wrs/aunisoma-hw/aunisoma-panel-controller/aunisoma-panel-controller.jpg

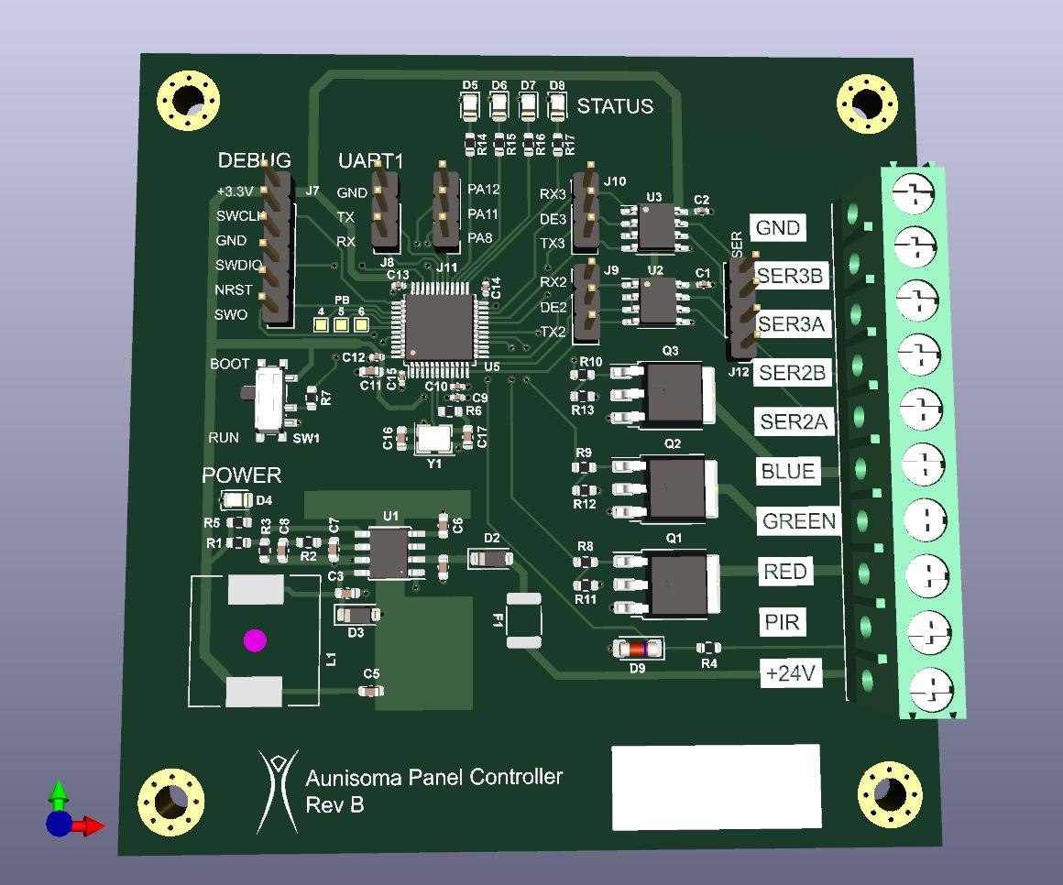
aunisoma-panel-controller/aunisoma-panel-controller.jpg
