wrs/aunisoma-hw/aunisoma-panel-controller/plot/aunisoma-panel-controller.pdf

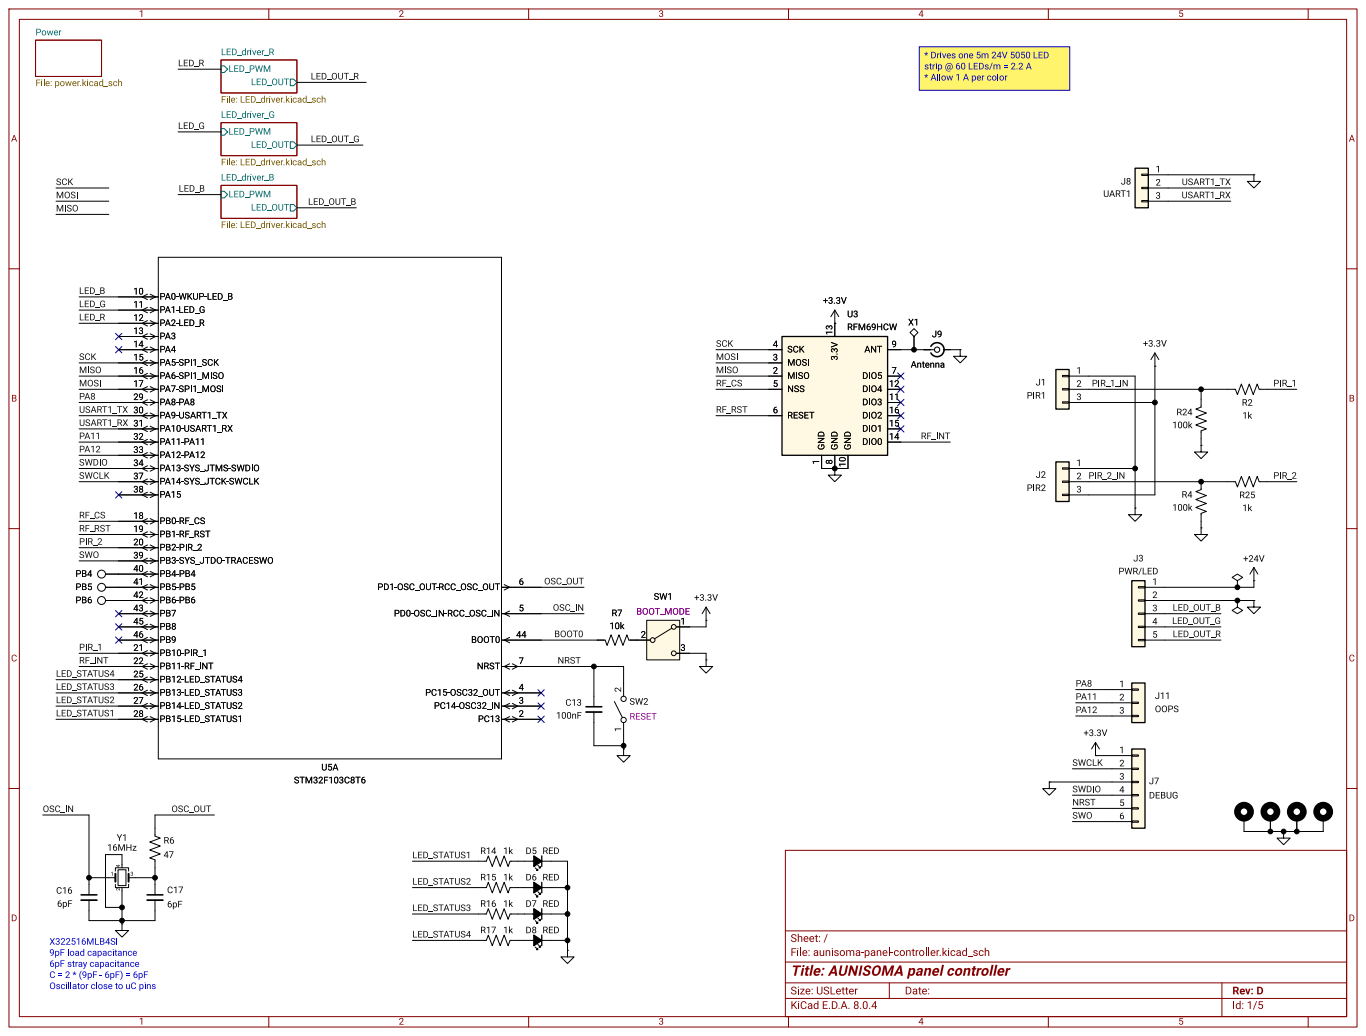
[picture p3: page 1]

File: LED_driver.kicad_sch Power File: power.kicad_sch

PIR_2 SWO MISO MOSI SCK

Id: 1/5 Title: AUNISOMApanelcontroller File: aunisoma-panel-controller.kicad_sch Sheet: /

6pF stray capacitance C = 2 * (9pF - 6pF) = 6pF Oscillator close to uC pins

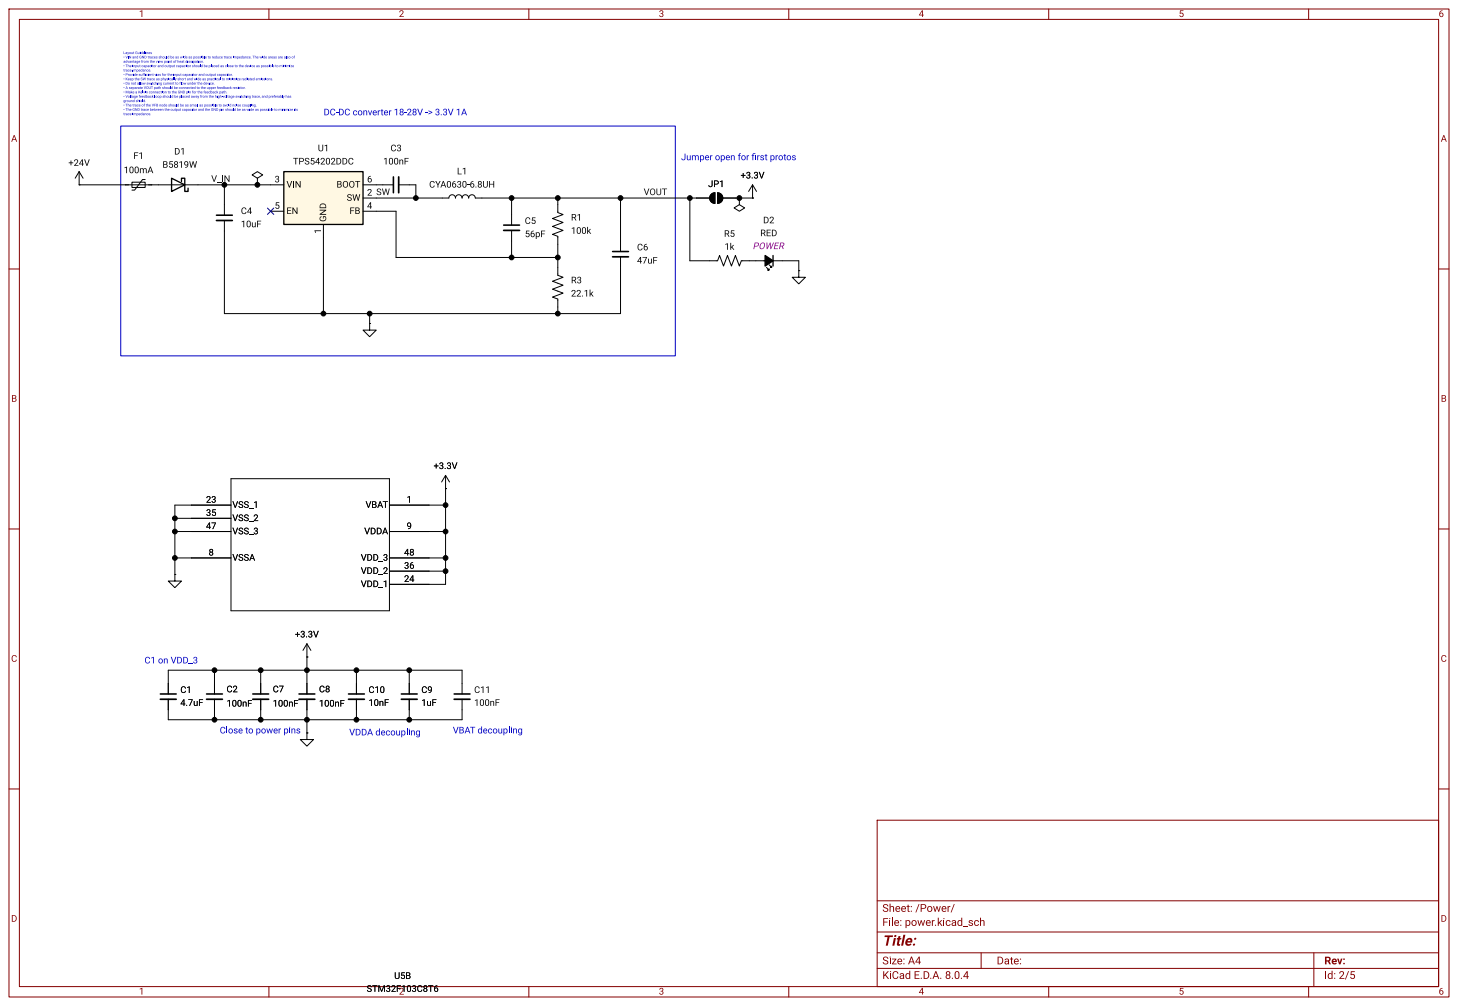
[picture p4: page 2]

Layout Guidelines þÿ " VIN and GNDtraces should be as wide as possible to reduce trace impedance. The wide areas are also of advantage from the view point of heat dissipation. þÿ " The input capacitor and output capacitor should be placed as close to the device as possible to minimize

trace impedance. þÿ " Provide sufficient vias for the input capacitor and output capacitor. þÿ " Keep the SWtrace as physically short and wide as practical to minimize radiated emissions. þÿ " Do not allow switching current to flow under the device. þÿ " A separate VOUTpath should be connected to the upper feedback resistor. þÿ " Make a Kelvin connection to the GNDpin for the feedback path. þÿ " Voltage feedback loop should be placed away from the high-voltage switching trace, and preferably has ground shield. þÿ " The trace of the VFBnode should be as small as possible to avoid noise coupling. þÿ " The GNDtrace between the output capacitor and the GNDpin should be as wide as possible to minimize its

Jumper open for first protos

Id: 2/5 Title: File: power.kicad_sch Sheet: /Power/ C11

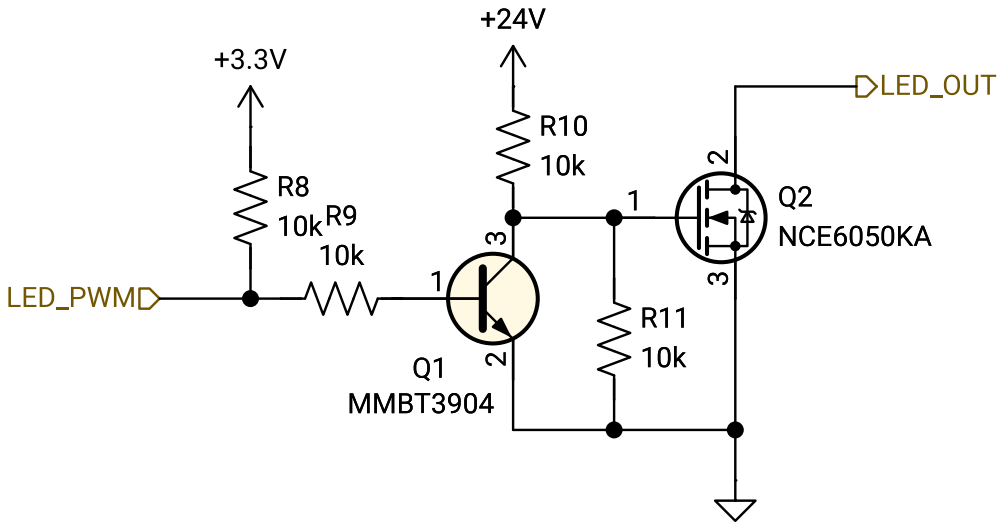
[picture p5: page 3]

Id: 3/5 Title: File: untitled.kicad_sch Sheet: /LED_driver_R/

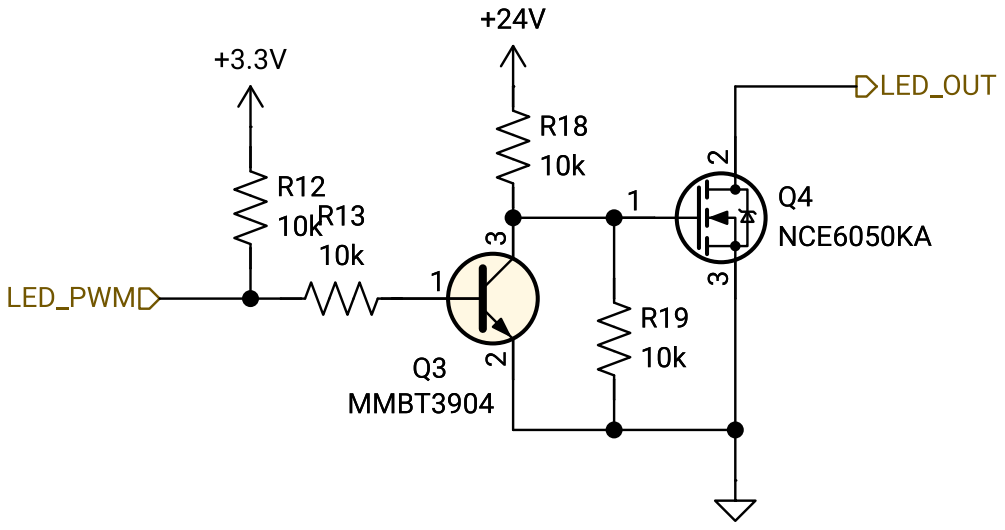
[picture p6: page 4]

Id: 4/5 Title: File: untitled.kicad_sch Sheet: /LED_driver_G/

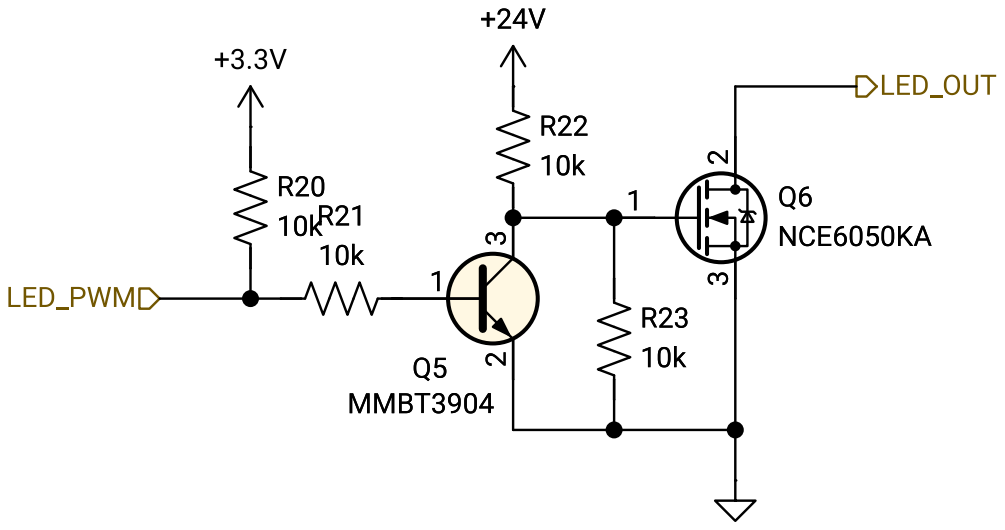
[picture p7: page 5]

Id: 5/5 Title: File: untitled.kicad_sch Sheet: /LED_driver_B/
