wrs/aunisoma-hw/aunisoma-panel-controller/plot/aunisoma-panel-controller-B_Cu.pdf

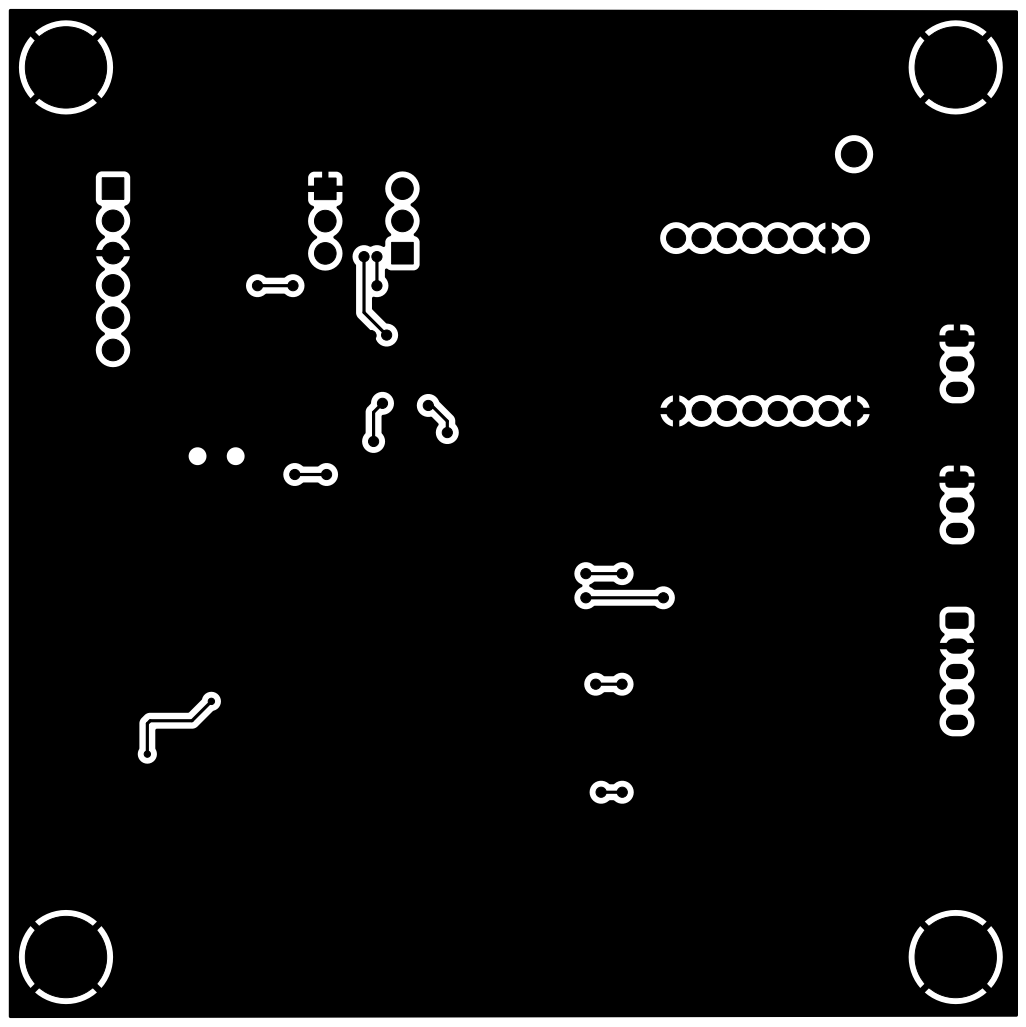
[picture p8: page 1]
