wrs/aunisoma-hw/aunisoma-panel-controller/plot/aunisoma-panel-controller-B_Mask.pdf

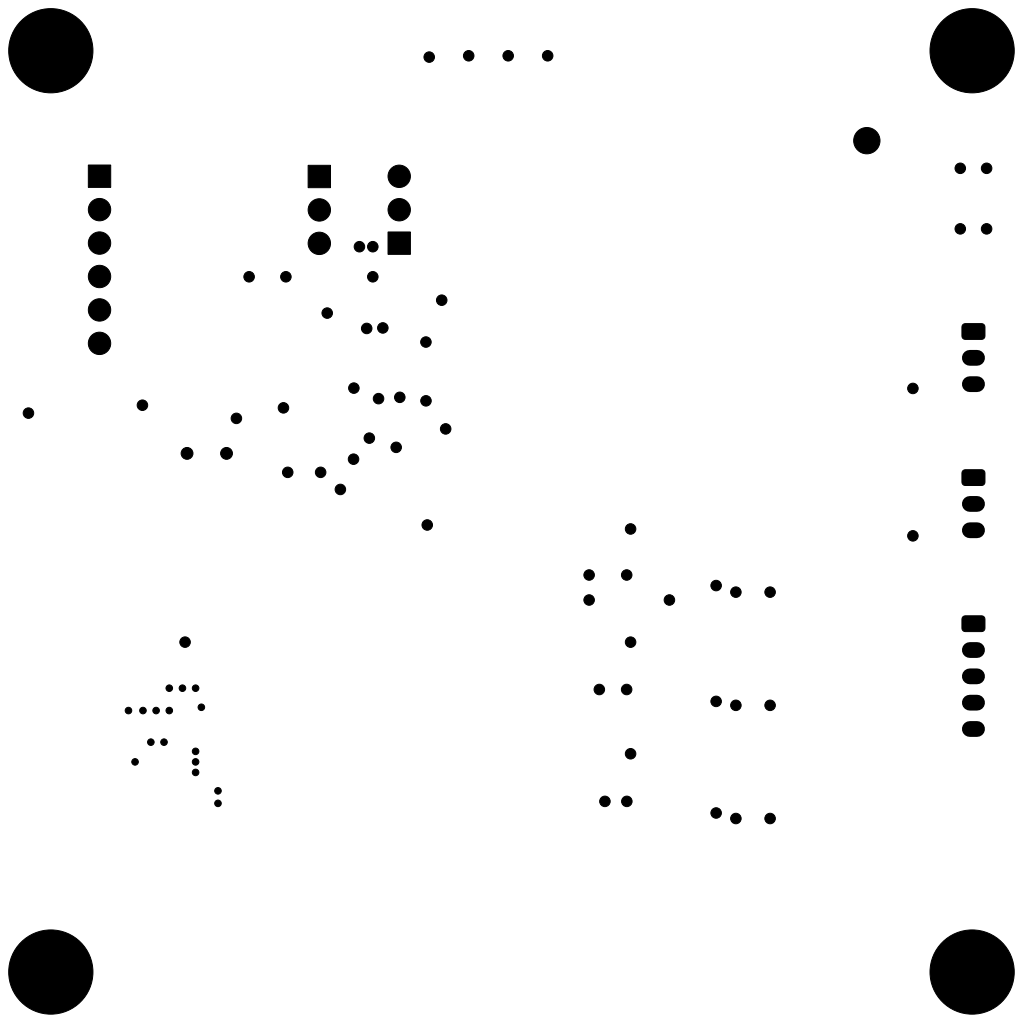
[picture p9: page 1]
