wrs/aunisoma-hw/aunisoma-panel-controller/plot/aunisoma-panel-controller-F_Cu.pdf

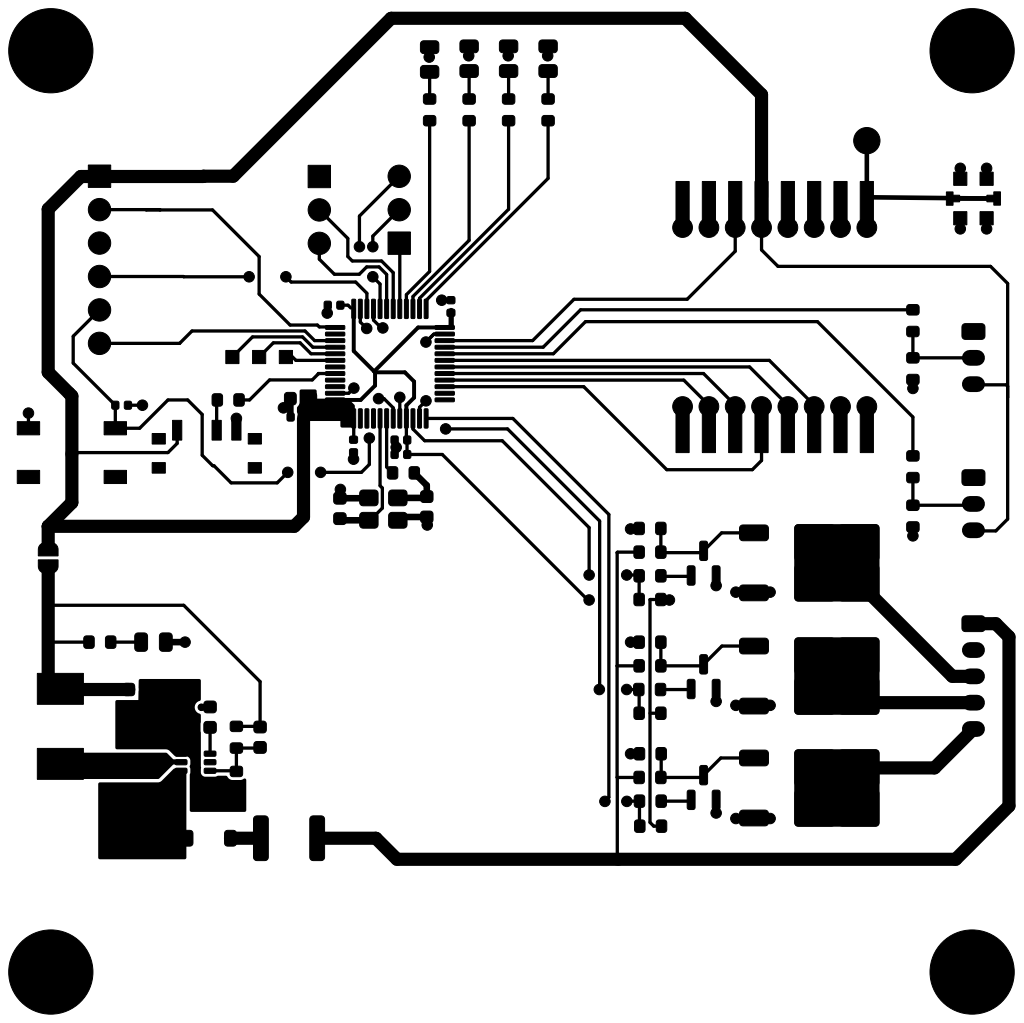
[picture p10: page 1]
