wrs/aunisoma-hw/aunisoma-panel-controller/plot/aunisoma-panel-controller-F_Mask.pdf

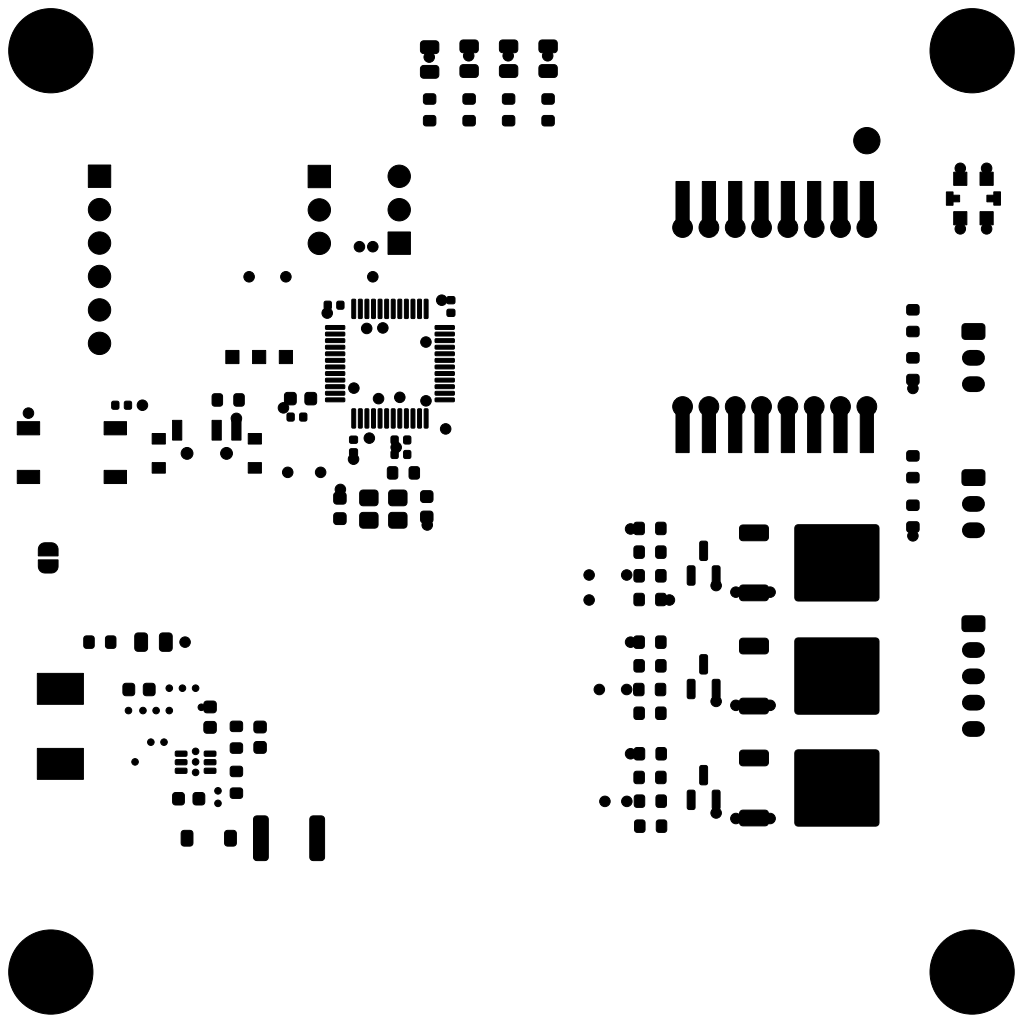
[picture p11: page 1]
