wrs/aunisoma-hw/aunisoma-panel-controller/plot/aunisoma-panel-controller-F_Paste.pdf

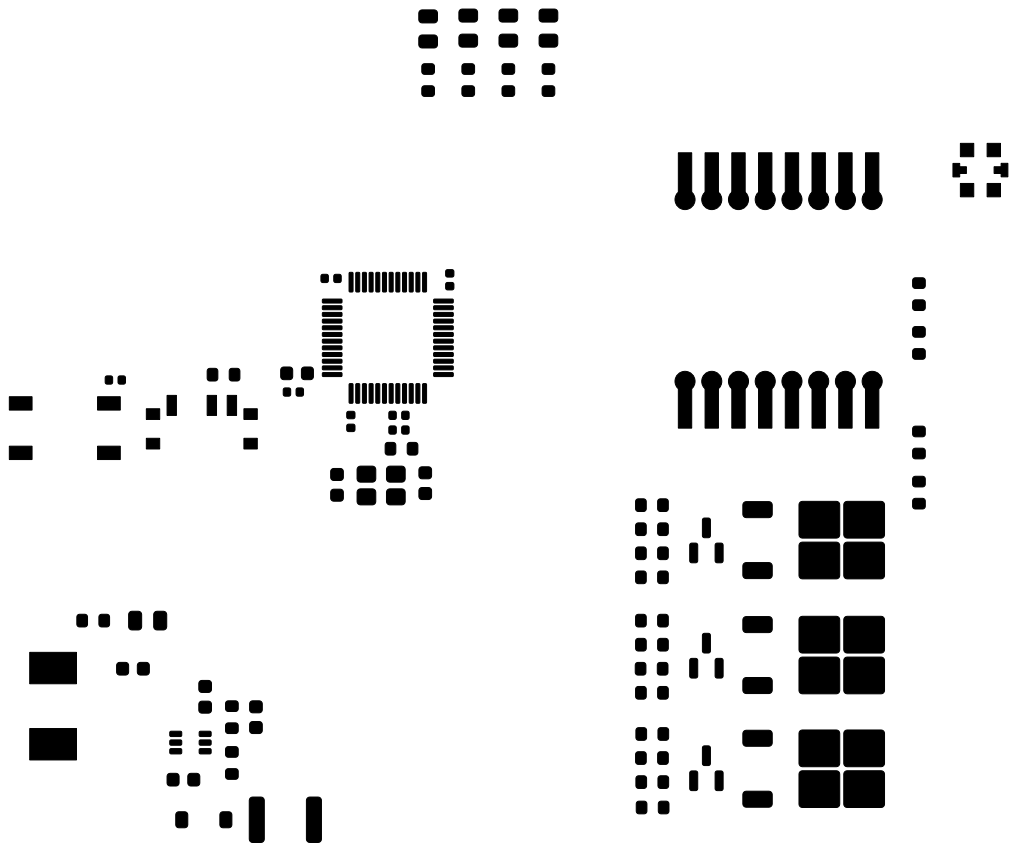
[picture p12: page 1]
