wrs/aunisoma-hw/aunisoma-panel-controller/plot/aunisoma-panel-controller-F_Silkscreen.pdf

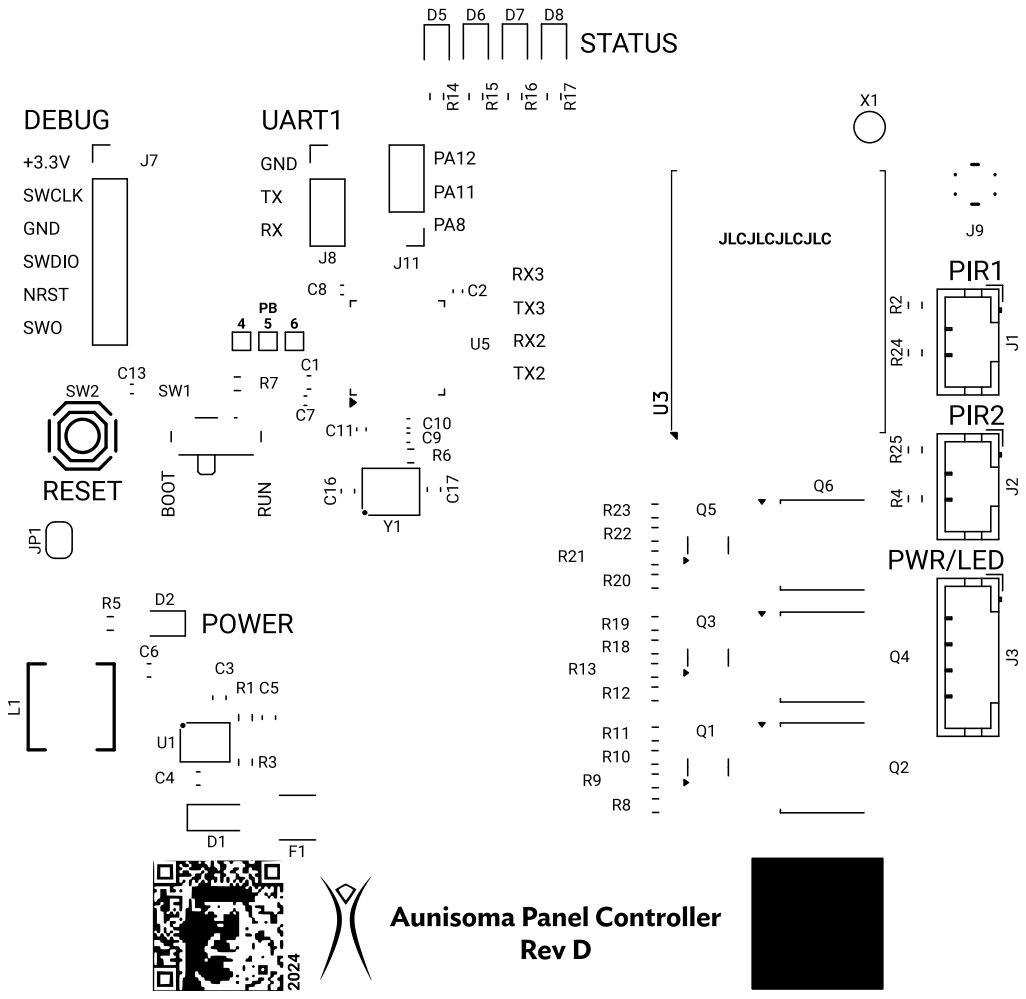
[picture p13: page 1]

JLCJLCJLCJLC NRST SWDIO DEBUG
