wrs/aunisoma-hw/aunisoma-pir/aunisoma-pir.kicad_pcb

## KiCad design aunisoma-pir/aunisoma-pir.kicad_pcb (2024-08-31)

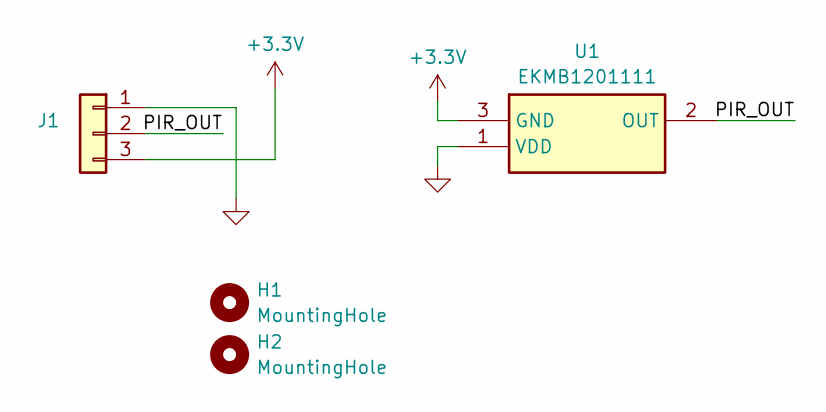
[picture p14: schematic aunisoma-pir.kicad_sch]

Parts:
H1, H2: MountingHole; MountingHole_3.2mm_M3
J1: PIR1; JST_PH_B3B-PH-K_1x03_P2.00mm_Vertical
U1: EKMB1201111; Mouser Part Number 769-EKMB1201111

Connections:
+3.3V: J1.3, U1.3 (GND)
/PIR_OUT: J1.2, U1.2 (OUT)
GND: J1.1, U1.1 (VDD)

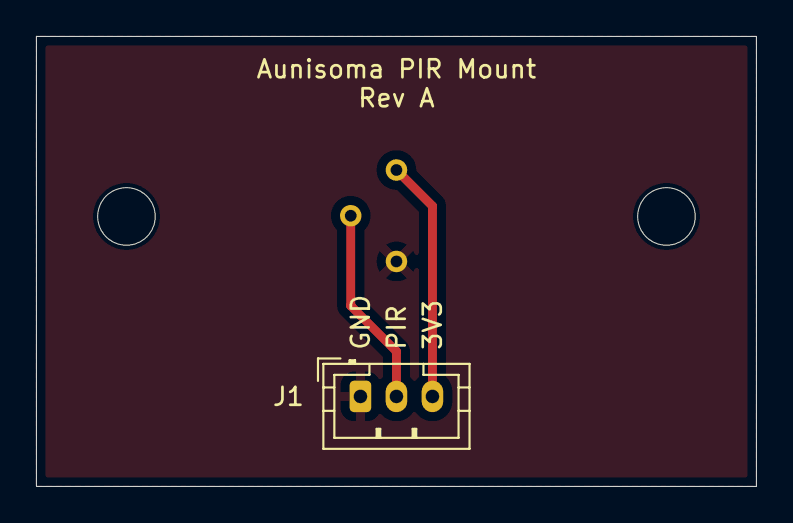
[picture p15: board aunisoma-pir.kicad_pcb from above]

Board: 2 copper layers, 40.0 x 25.0 mm, 4 parts (1 on the bottom side), 3 nets.
