wrs/aunisoma-hw/aunisoma-panel-controller/aunisoma-panel-controller.kicad_pcb

## KiCad design aunisoma-panel-controller/aunisoma-panel-controller.kicad_pcb (2024-08-31)

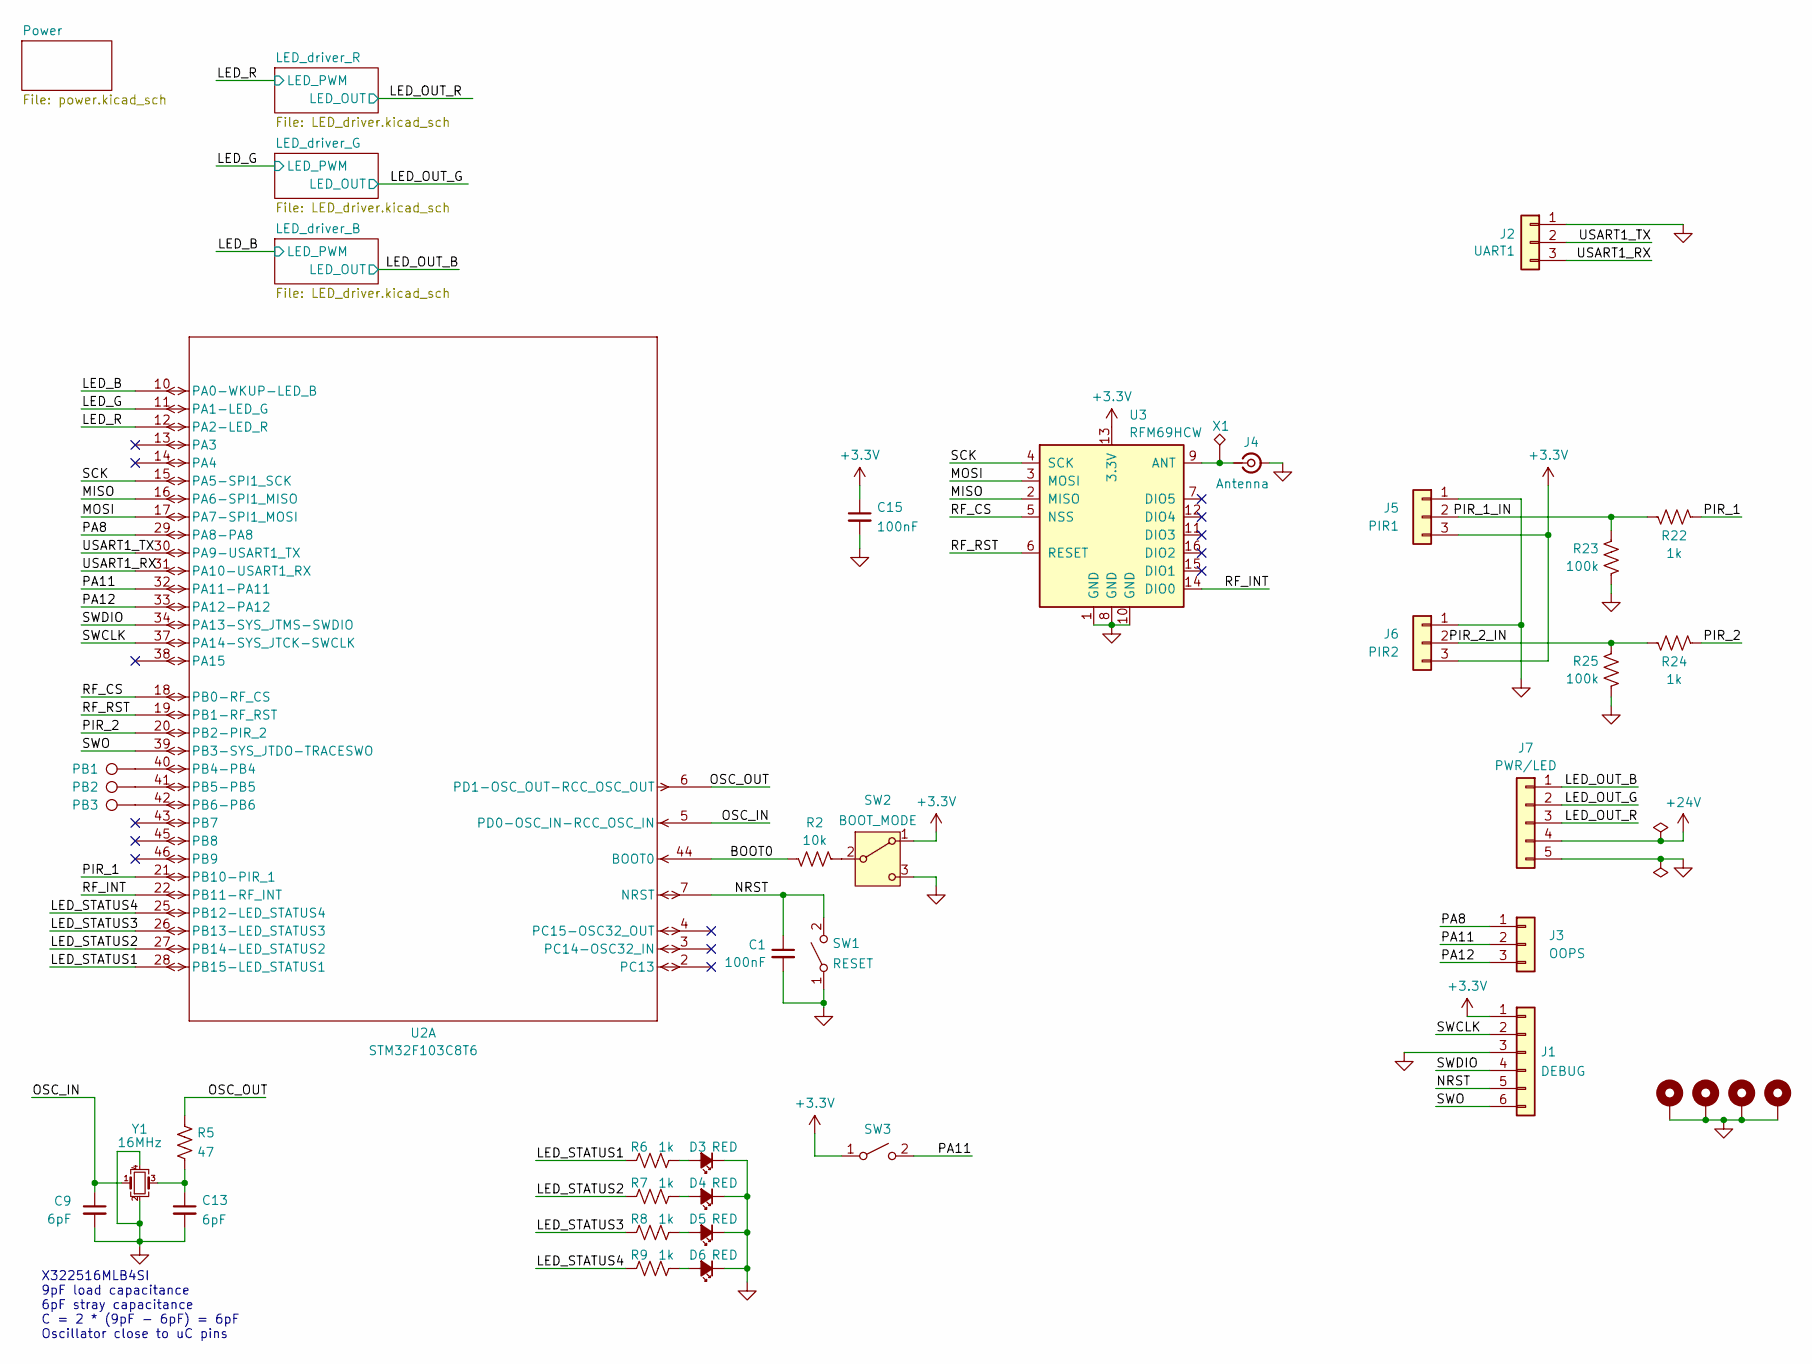
[picture p16: schematic aunisoma-panel-controller.kicad_sch, AUNISOMA panel controller]

Parts:
C1, C15: 100nF; C_0402_1005Metric; LCSC C1525
C9, C13: 6pF; C_0603_1608Metric; LCSC C37474
D3, D4, D5, D6: RED; LED_0805_2012Metric; LCSC C84256
H1, H2, H3, H4: MountingHole_Pad; MountingHole_3.2mm_M3_Pad_Via
J1: DEBUG; PinHeader_1x06_P2.54mm_Vertical
J2: UART1; PinHeader_1x03_P2.54mm_Vertical
J3: OOPS; PinHeader_1x03_P2.54mm_Vertical
J4: Conn_Coaxial_Small; IPEX-SMD_KMC1001-F007-7F; LCSC C426219
J5: PIR1; JST_PH_B3B-PH-K_1x03_P2.00mm_Vertical
J6: PIR2; JST_PH_B3B-PH-K_1x03_P2.00mm_Vertical
J7: PWR/LED; JST_PH_B5B-PH-K_1x05_P2.00mm_Vertical; LCSC C158028
PB1, PB2, PB3: TestPoint; TestPoint_Pad_1.0x1.0mm
R2: 10k; R_0603_1608Metric; LCSC C25804
R5: 47; R_0603_1608Metric; LCSC C23182
R6, R7, R8, R9: 1k; R_0603_1608Metric; LCSC C8218
R22, R24: 1k; R_0603_1608Metric; LCSC C25803
R23, R25: 100k; R_0603_1608Metric; LCSC C25803
SW1, SW3: SW-SMD_4P-L5.1-W5.1-P3.70-LS6.5-TL-2
SW2: SW_SPDT_PCM12; LCSC C109335
U2: STM32F103C8T6; LQFP-48_7x7mm_P0.5mm; LCSC C8734
U3: RFM69HCW; HOPERF_RFM69HW_SMD_TH
X1: Antenna; TestPoint_THTPad_D2.0mm_Drill1.0mm
Y1: 16MHz; Crystal_SMD_3225-4Pin_3.2x2.5mm; LCSC C13738

Connections:
+3.3V: C15.1, J1.1, J5.3, J6.3, SW2.1 (A), SW3.1 (A), U3.13 (3.3V); also elsewhere on the board
+24V: J7.4; also elsewhere on the board
/BOOT0: R2.2, U2.44 (BOOT0)
/LED_B: U2.10 (PA0-WKUP-LED_B); also elsewhere on the board
/LED_G: U2.11 (PA1-LED_G); also elsewhere on the board
/LED_OUT_B: J7.1; also elsewhere on the board
/LED_OUT_G: J7.2; also elsewhere on the board
/LED_OUT_R: J7.3; also elsewhere on the board
/LED_R: U2.12 (PA2-LED_R); also elsewhere on the board
/LED_STATUS1: R6.2, U2.28 (PB15-LED_STATUS1)
/LED_STATUS2: R7.2, U2.27 (PB14-LED_STATUS2)
/LED_STATUS3: R8.2, U2.26 (PB13-LED_STATUS3)
/LED_STATUS4: R9.2, U2.25 (PB12-LED_STATUS4)
/MISO: U2.16 (PA6-SPI1_MISO), U3.2 (MISO)
/MOSI: U2.17 (PA7-SPI1_MOSI), U3.3 (MOSI)
/NRST: C1.1, J1.5, SW1.2 (B), U2.7 (NRST)
/OSC_IN: C9.1, U2.5 (PD0-OSC_IN-RCC_OSC_IN), Y1.1
/OSC_OUT: R5.2, U2.6 (PD1-OSC_OUT-RCC_OSC_OUT)
/PA8: J3.1, U2.29 (PA8-PA8)
/PA11: J3.2, SW3.2 (B), U2.32 (PA11-PA11)
/PA12: J3.3, U2.33 (PA12-PA12)
/PIR_1: R22.1, U2.21 (PB10-PIR_1)
/PIR_1_IN: J5.2, R22.2, R23.2
/PIR_2: R24.1, U2.20 (PB2-PIR_2)
/PIR_2_IN: J6.2, R24.2, R25.2
/RF_CS: U2.18 (PB0-RF_CS), U3.5 (NSS)
/RF_INT: U2.22 (PB11-RF_INT), U3.14 (DIO0)
/RF_RST: U2.19 (PB1-RF_RST), U3.6 (RESET)
/SCK: U2.15 (PA5-SPI1_SCK), U3.4 (SCK)
/SWCLK: J1.2, U2.37 (PA14-SYS_JTCK-SWCLK)
/SWDIO: J1.4, U2.34 (PA13-SYS_JTMS-SWDIO)
/SWO: J1.6, U2.39 (PB3-SYS_JTDO-TRACESWO)
/USART1_RX: J2.3, U2.31 (PA10-USART1_RX)
/USART1_TX: J2.2, U2.30 (PA9-USART1_TX)
GND: C1.2, C9.2, C13.2, C15.2, D3.1 (K), D4.1 (K), D5.1 (K), D6.1 (K), H1.1, H2.1, H3.1, H4.1, J1.3, J2.1, J4.2 (Ext), J5.1, J6.1, J7.5, R23.1, R25.1, SW1.1 (A), SW2.3 (C), U3.1 (GND), U3.8 (GND), U3.10 (GND), Y1.2, Y1.4; also elsewhere on the board
unnamed: C13.1, R5.1, Y1.3
unnamed: D3.2 (A), R6.1
unnamed: D4.2 (A), R7.1
unnamed: D5.2 (A), R8.1
unnamed: D6.2 (A), R9.1
unnamed: J4.1 (In), U3.9 (ANT), X1.1
unnamed: R2.1, SW2.2 (B)
unnamed: PB1.1, U2.40 (PB4-PB4)
unnamed: PB2.1, U2.41 (PB5-PB5)
unnamed: PB3.1, U2.42 (PB6-PB6)

Notes on the sheet:
X322516MLB4SI 9pF load capacitance 6pF stray capacitance C = 2 * (9pF - 6pF) = 6pF Oscillator close to uC pins

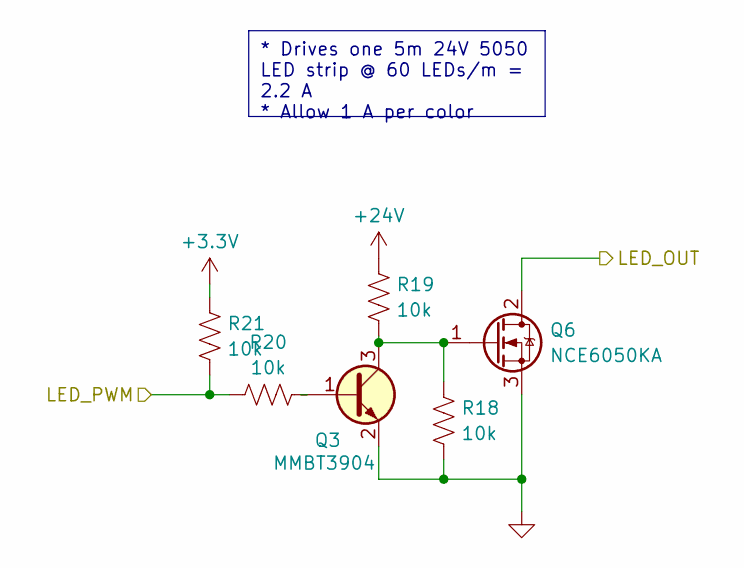
[picture p17: schematic LED_driver.kicad_sch]

Parts:
Q3: MMBT3904; SOT-23; LCSC C20526
Q6: NCE6050KA; TO-252-2; LCSC C620154
R18, R19, R20, R21: 10k; R_0603_1608Metric; LCSC C25803

Connections:
+3.3V: R21.2; also elsewhere on the board
+24V: R19.2; also elsewhere on the board
/LED_OUT_R: Q6.2 (D); also elsewhere on the board
/LED_R: R20.2, R21.1; also elsewhere on the board
GND: Q3.2 (E), Q6.3 (S), R18.1; also elsewhere on the board
unnamed: Q3.1 (B), R20.1
unnamed: Q3.3 (C), Q6.1 (G), R18.2, R19.1

Parts of its further copies:
Q1, Q2: MMBT3904; SOT-23; LCSC C20526
Q4, Q5: NCE6050KA; TO-252-2; LCSC C620154
R10, R11, R12, R13, R14, R15, R16, R17: 10k; R_0603_1608Metric; LCSC C25803

Connections of its further copies:
+3.3V: R13.2, R17.2; also elsewhere on the board
+24V: R11.2, R15.2; also elsewhere on the board
/LED_B: R12.2, R13.1; also elsewhere on the board
/LED_G: R16.2, R17.1; also elsewhere on the board
/LED_OUT_B: Q4.2 (D); also elsewhere on the board
/LED_OUT_G: Q5.2 (D); also elsewhere on the board
GND: Q1.2 (E), Q2.2 (E), Q4.3 (S), Q5.3 (S), R10.1, R14.1; also elsewhere on the board
unnamed: Q1.1 (B), R12.1
unnamed: Q1.3 (C), Q4.1 (G), R10.2, R11.1
unnamed: Q2.1 (B), R16.1
unnamed: Q2.3 (C), Q5.1 (G), R14.2, R15.1

Notes on the sheet:
* Drives one 5m 24V 5050 LED strip @ 60 LEDs/m = 2.2 A * Allow 1 A per color

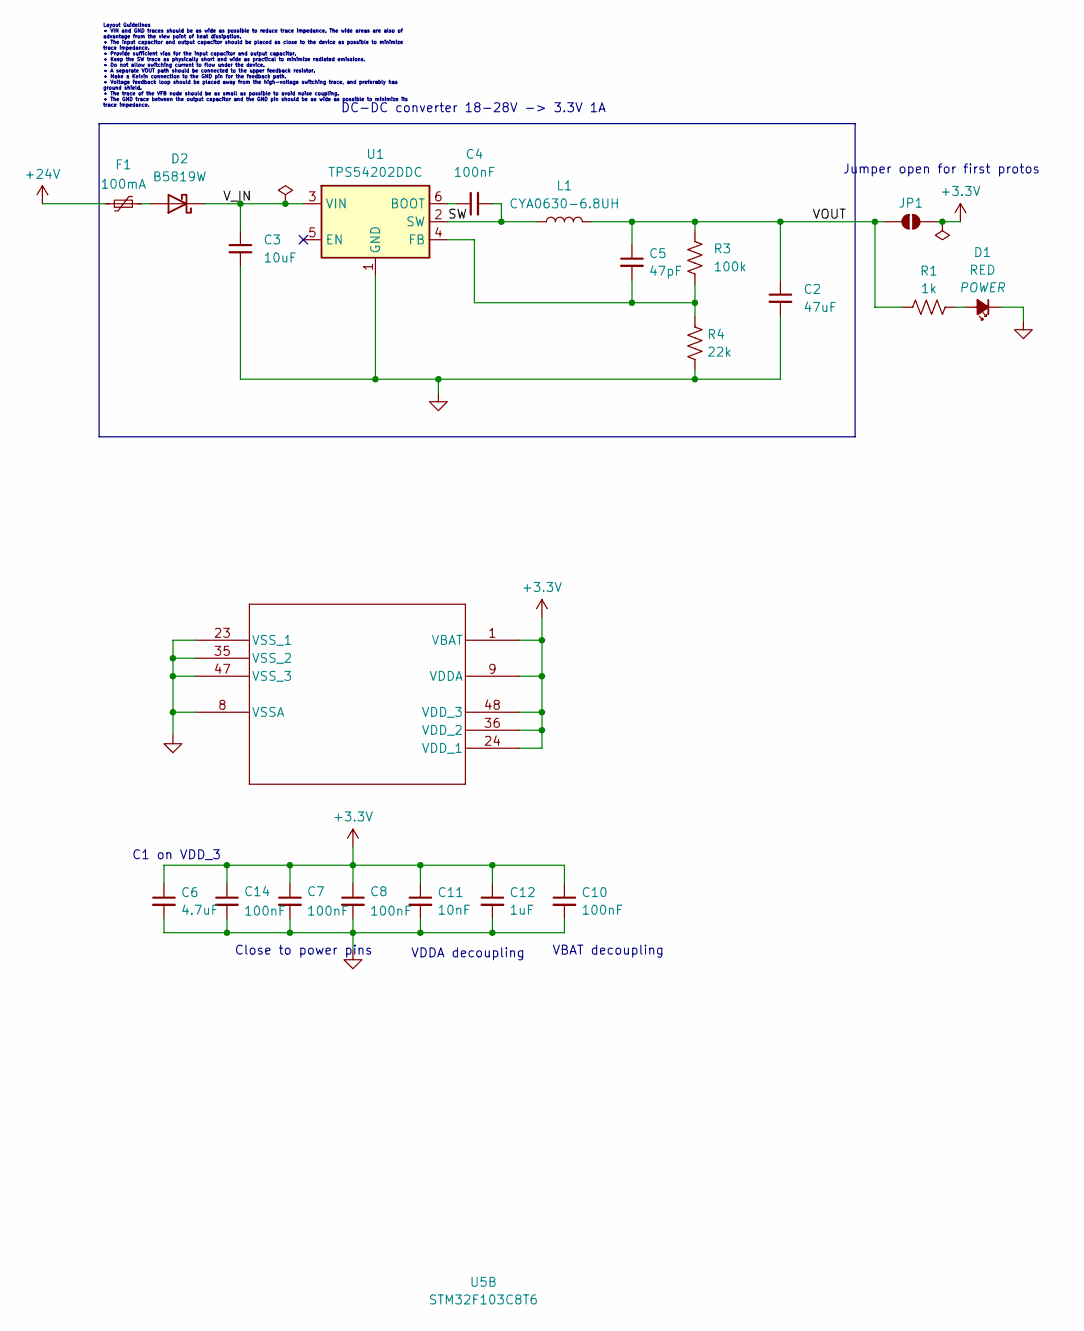
[picture p18: schematic power.kicad_sch]

Parts:
C2: 47uF; C_1206_3216Metric; LCSC C21122
C3: 10uF; C_0603_1608Metric; LCSC C96446
C4: 100nF; C_0603_1608Metric; LCSC C14663
C5: 47pF; C_0603_1608Metric; LCSC C96446
C6: 4.7uF; C_0603_1608Metric; LCSC C96446
C7, C8, C10, C14: 100nF; C_0402_1005Metric; LCSC C1525
C11: 10nF; C_0402_1005Metric; LCSC C1525
C12: 1uF; C_0402_1005Metric; LCSC C52923
D1: RED; LED_0805_2012Metric; LCSC C84256
D2: B5819W; D_SOD-123; LCSC C8598
F1: 100mA; Fuse_1812_4532Metric; LCSC C2760281
JP1: SolderJumper_2_Bridged; SolderJumper-2_P1.3mm_Open_RoundedPad1.0x1.5mm
L1: CYA0630-6.8UH; IND-SMD_L7.2-W6.6_GPSR0730; LCSC C5189749
R1: 1k; R_0603_1608Metric; LCSC C8218
R3: 100k; R_0603_1608Metric; LCSC C22790
R4: 22k; R_0603_1608Metric; LCSC C23018
U1: TPS54202DDC; SOT-23-6; LCSC C191884
U5: STM32F103C8T6; LQFP-48_7x7mm_P0.5mm; LCSC C8734

Connections:
+3.3V: C6.1, C7.1, C8.1, C10.1, C11.1, C12.1, C14.1, JP1.2 (B); also elsewhere on the board
+24V: F1.1; also elsewhere on the board
/Power/SW: C4.2, L1.1, U1.2 (SW)
/Power/VOUT: C2.1, C5.1, JP1.1 (A), L1.2, R1.2, R3.1
/Power/V_IN: C3.1, D2.1 (K), U1.3 (VIN)
GND: C2.2, C3.2, C6.2, C7.2, C8.2, C10.2, C11.2, C12.2, C14.2, D1.1 (K), R4.2, U1.1 (GND); also elsewhere on the board
unnamed: D1.2 (A), R1.1
unnamed: D2.2 (A), F1.2
unnamed: C4.1, U1.6 (BOOT)
unnamed: C5.2, R3.2, R4.1, U1.4 (FB)

Notes on the sheet:
DC-DC converter 18-28V -> 3.3V 1A
Jumper open for first protos
VDDA decoupling
Layout Guidelines • VIN and GND traces should be as wide as possible to reduce trace impedance. The wide areas are also of advantage from the view point of heat dissipation. • The input capacitor and output capacitor should be placed as close to the device as possible to minimize trace impedance. •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
C1 on VDD_3
Close to power pins
VBAT decoupling

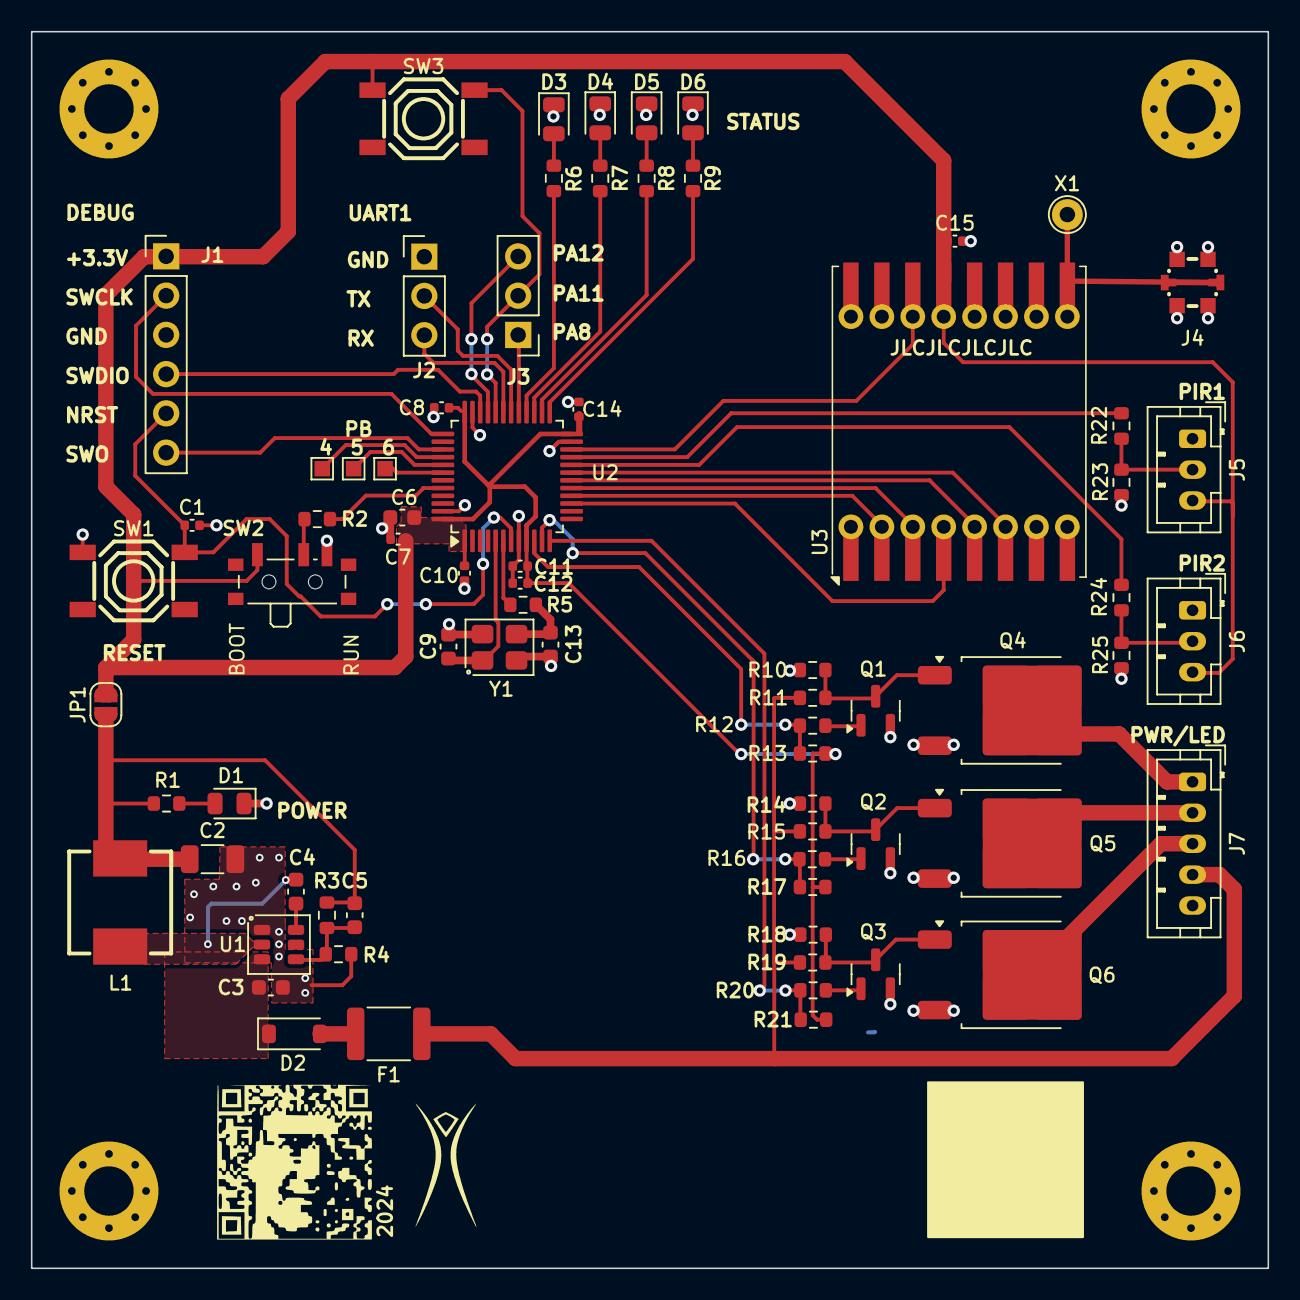
[picture p19: board aunisoma-panel-controller.kicad_pcb from above]

Board: 2 copper layers, 80.0 x 80.0 mm, 78 parts (0 on the bottom side), 58 nets.

Other parts of the board:
LOGO: LOGO
