wrs/aunisoma-hw/aunisoma-panel-controller/aunisoma-panel-controller-D-pre-radio.kicad_pcb

## KiCad design aunisoma-panel-controller/aunisoma-panel-controller-D-pre-radio.kicad_pcb (2024-08-31)

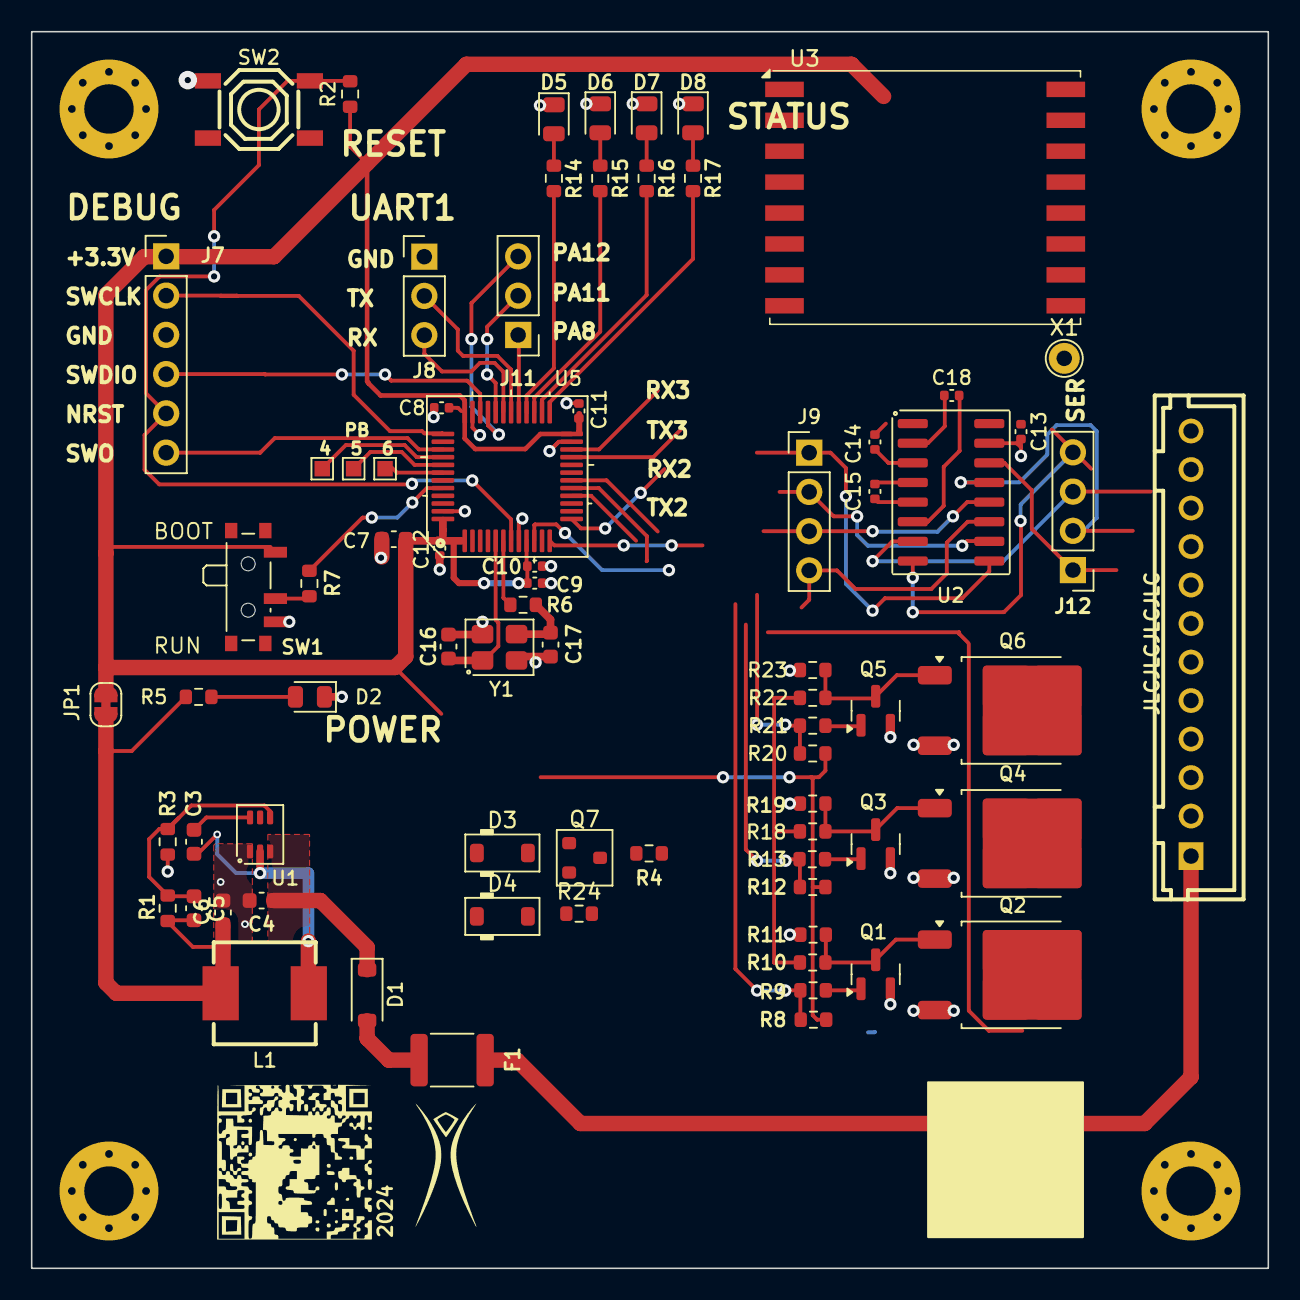
[picture p20: board aunisoma-panel-controller-D-pre-radio.kicad_pcb from above]

Board: 2 copper layers, 80.0 x 80.0 mm, 80 parts (0 on the bottom side), 64 nets.

Parts:
C3: 100nF; C_0603_1608Metric
C4, C7: 10uF; C_0603_1608Metric
C5: 56pF; C_0603_1608Metric
C6: 47uF; C_0603_1608Metric
C8, C9, C11, C12, C13, C14, C15, C18: 100nF; C_0402_1005Metric
C10: 1uF; C_0402_1005Metric
C16, C17: 6pF; C_0603_1608Metric
D1: B5819W; D_SOD-123
D2, D5, D6, D7, D8: RED; LED_0805_2012Metric
D3, D4: 1N4148; D_SOD-123
F1: 100mA; Fuse_1812_4532Metric
H1, H2, H3, H4: MountingHole_Pad; MountingHole_3.2mm_M3_Pad_Via
J3: PWR/PERIPH; CONN-TH_B12B-XH-A-LF-SN
J7: DEBUG; PinHeader_1x06_P2.54mm_Vertical
J8: UART1; PinHeader_1x03_P2.54mm_Vertical
J9: TEST; PinHeader_1x04_P2.54mm_Vertical
J11: OOPS; PinHeader_1x03_P2.54mm_Vertical
J12: SER23; PinHeader_1x04_P2.54mm_Vertical
JP1: SolderJumper_2_Bridged; SolderJumper-2_P1.3mm_Bridged_RoundedPad1.0x1.5mm
L1: CYA0630-6.8UH; IND-SMD_L7.2-W6.6_GPSR0730
LOGO: LOGO
PB4, PB5, PB6: TestPoint; TestPoint_Pad_1.0x1.0mm
Q1, Q3, Q5: MMBT3904; SOT-23
Q2, Q4, Q6: NCE6050KA; TO-252-2
Q7: 2N7002AQ; SOT-23
R1, R24: 100k; R_0603_1608Metric
R2, R4, R7, R8, R9, R10, R11, R12, R13, R18, R19, R20, R21, R22, R23: 10k; R_0603_1608Metric
R3: 22.1k; R_0603_1608Metric
R5, R14, R15, R16, R17: 1k; R_0603_1608Metric
R6: 47; R_0603_1608Metric
SW1: SW_SPDT_PCM12
SW2: SW-SMD_4P-L5.1-W5.1-P3.70-LS6.5-TL-2
U1: TPS54202DDC; Texas_R-PDSO-G6
U2: SP3232EU; SOIC-16_3.9x9.9mm_P1.27mm
U3: RFM69HCW; HOPERF_RFM69HW
U5: STM32F103C8T6; LQFP-48_7x7mm_P0.5mm
X1: Antenna; TestPoint_THTPad_D2.0mm_Drill1.0mm
Y1: 16MHz; Crystal_SMD_3225-4Pin_3.2x2.5mm

Connections:
+3.3V: C7.1, C8.1, C9.1, C10.1, C11.1, C12.1, C13.1, J7.1, JP1.2 (B), R2.1, R4.1, R8.2, R12.2, R20.2, SW1.1 (A), U2.16 (VCC), U3.13 (3.3V), U5.1 (VBAT), U5.9 (VDDA), U5.24 (VDD), U5.36 (VDD), U5.48 (VDD)
+24V: F1.1, J3.1, R10.2, R18.2, R22.2
/BOOT0: R7.2, U5.44 (BOOT0)
/LED_B: R20.1, R21.2, U5.18 (PB0)
/LED_G: R12.1, R13.2, U5.17 (PA7)
/LED_OUT_B: J3.7, Q6.2 (D)
/LED_OUT_G: J3.6, Q4.2 (D)
/LED_OUT_R: J3.5, Q2.2 (D)
/LED_R: R8.1, R9.2, U5.16 (PA6)
/LED_STATUS1: R14.2, U5.28 (PB15)
/LED_STATUS2: R15.2, U5.27 (PB14)
/LED_STATUS3: R16.2, U5.26 (PB13)
/LED_STATUS4: R17.2, U5.25 (PB12)
/OSC_IN: C16.1, U5.5 (PD0), Y1.1
/OSC_OUT: R6.2, U5.6 (PD1)
/PIR_IN: Q7.3 (D), R4.2
/Power/VOUT: C5.1, C6.1, JP1.1 (A), L1.2, R1.1, R5.2
/SER2_RX: J3.9, J12.2, U2.13 (R1IN)
/SER2_TX: J3.8, J12.1, U2.14 (T1OUT)
/SER3_RX: J3.11, J12.4, U2.8 (R2IN)
/SER3_TX: J3.10, J12.3, U2.7 (T2OUT)
/USART1_RX: J8.3, U5.31 (PA10)
/USART1_TX: J8.2, U5.30 (PA9)
/USART2_RX: J9.3, U2.12 (R1OUT), U5.13 (PA3)
/USART2_TX: J9.4, U2.11 (T1IN), U5.12 (PA2)
/USART3_RX: J9.1, U2.9 (R2OUT), U5.22 (PB11)
/USART3_TX: J9.2, U2.10 (T2IN), U5.21 (PB10)
GND: C4.2, C6.2, C7.2, C8.2, C9.2, C10.2, C11.2, C12.2, C13.2, C16.2, C17.2, D2.1 (K), D5.1 (K), D6.1 (K), D7.1 (K), D8.1 (K), H1.1, H2.1, H3.1, H4.1, J3.12, J7.3, J8.1, Q1.2 (E), Q2.3 (S), Q3.2 (E), Q4.3 (S), Q5.2 (E), Q6.3 (S), Q7.2 (S), R3.2, R11.1, R19.1, R23.1, R24.1, SW1.3 (C), SW2.1 (A), U1.1 (GND), U2.15 (GND), U3.1 (GND), U3.8 (GND), U3.10 (GND), U5.8 (VSSA), U5.23 (VSS), U5.35 (VSS), U5.47 (VSS), Y1.2, Y1.4
NRST: J7.5, R2.2, SW2.2 (B), U5.7 (NRST)
unnamed: C17.1, R6.1, Y1.3
unnamed: D1.2 (A), F1.2
unnamed: C4.1, D1.1 (K), U1.3 (VIN)
unnamed: D2.2 (A), R5.1
unnamed: D3.1 (K), D4.1 (K), Q7.1 (G), R24.2
unnamed: D5.2 (A), R14.1
unnamed: D6.2 (A), R15.1
unnamed: D7.2 (A), R16.1
unnamed: D8.2 (A), R17.1
unnamed: Q1.1 (B), R9.1
unnamed: Q1.3 (C), Q2.1 (G), R10.1, R11.2
unnamed: Q3.1 (B), R13.1
unnamed: Q3.3 (C), Q4.1 (G), R18.1, R19.2
unnamed: Q5.1 (B), R21.1
unnamed: Q5.3 (C), Q6.1 (G), R22.1, R23.2
unnamed: R7.1, SW1.2 (B)
unnamed: C3.1, U1.6 (BOOT)
unnamed: C5.2, R1.2, R3.1, U1.4 (FB)
unnamed: C3.2, L1.1, U1.2 (SW)
unnamed: C14.1, U2.1 (C1+)
unnamed: C14.2, U2.3 (C1-)
unnamed: C15.1, U2.4 (C2+)
unnamed: C15.2, U2.5 (C2-)
unnamed: C18.1, U2.2 (V+)
unnamed: C18.2, U2.6 (V-)
unnamed: U3.9 (ANT), X1.1
PA8: J11.1, U5.29 (PA8)
PA11: J11.2, U5.32 (PA11)
PA12: J11.3, U5.33 (PA12)
PB4: PB4.1, U5.40 (PB4)
PB5: PB5.1, U5.41 (PB5)
PB6: PB6.1, U5.42 (PB6)
SWCLK: J7.2, U5.37 (PA14)
SWDIO: J7.4, U5.34 (PA13)
SWO: J7.6, U5.39 (PB3)
